tillig/MarantzVolumeMonitor/docs/architecture.md

# Architecture Reference

## Layers

The firmware uses a small layered architecture:

- **UI layer**: Screens, display rendering, touch handling, and screen navigation.
- **Network layer**: Wi-Fi connection management, SSDP/UPnP receiver discovery, and Marantz HTTP status access.
- **Storage layer**: Persistent device configuration using LittleFS.
- **Hardware layer**: TFT_eSPI display access and XPT2046 touch input.
- **Diagnostics**: An in-memory event log that any layer may write to, read by `DiagnosticsScreen` and `DiagnosticsServer`.

Screens should not perform network I/O directly. They should delegate network work to the network layer and persistence to `ConfigStore`.

## Source Layout

```text
src/
├── main.cpp
├── diagnostics/
│   ├── DeviceInfo.h/.cpp
│   └── DiagnosticLog.h/.cpp
├── network/
│   ├── DiagnosticsServer.h/.cpp
│   ├── MarantzClient.h/.cpp
│   ├── ReceiverDiscovery.h/.cpp
│   ├── ReceiverMonitor.h/.cpp
│   └── WiFiManager.h/.cpp
├── storage/
│   └── ConfigStore.h/.cpp
└── ui/
    ├── DisplayManager.h/.cpp
    ├── IconRenderer.h/.cpp
    ├── MaterialStyle.h/.cpp
    ├── ScreenManager.h/.cpp
    ├── TouchManager.h/.cpp
    ├── assets/
    │   └── IconBitmaps.h/.cpp
    └── Screens/
        ├── HomeScreen.h/.cpp
        ├── SettingsScreen.h/.cpp
        ├── CurrentSettingsScreen.h/.cpp
        ├── DiagnosticsScreen.h/.cpp
        ├── NetworkListScreen.h/.cpp
        ├── KeyboardScreen.h/.cpp
        ├── SetupStatusScreen.h/.cpp
        ├── ReceiverListScreen.h/.cpp
        ├── ReceiverIpScreen.h/.cpp
        ├── ReceiverStatusScreen.h/.cpp
        ├── ResetDefaultsScreen.h/.cpp
        └── CalibrationScreen.h/.cpp
```

Feature work may add classes inside these existing layer folders. New cross-layer behavior should keep the ownership boundary clear: UI presents state and handles touch, network classes perform network operations, and storage classes read or write persistent configuration.

## Runtime Flow

1. Boot initializes display, touch, and LittleFS-backed configuration storage, then attempts Wi-Fi auto-connect, applies any saved receiver IP, restores the saved touch-calibration profile if it is usable, and starts the diagnostics HTTP server. `WiFiManager` retries the saved network from the main loop whenever it stays disconnected.
2. `HomeScreen` is the first screen and classifies the current state as Wi-Fi setup required, Wi-Fi connecting, receiver setup required, receiver connecting, receiver unavailable, receiver off, or live.
3. If Wi-Fi is not configured, the touchscreen flow branches through `NetworkListScreen`, `KeyboardScreen`, and `SetupStatusScreen` to collect and save credentials.
4. If a receiver is not configured, the setup flow branches through `ReceiverListScreen`, `ReceiverIpScreen`, and `ReceiverStatusScreen` to discover or verify a receiver address before saving it.
5. `SettingsScreen` provides access to `Current Settings`, `Volume Display Scale`, Wi-Fi setup, receiver setup, touch calibration, `Diagnostics`, and `Reset To Defaults`, with pagination when all entries do not fit cleanly on one page.
6. `ReceiverMonitor` polls the saved receiver about once per second on a background FreeRTOS task, so status fetches never block the UI loop, and pauses when no screen has read status for a few seconds. `HomeScreen` redraws as soon as a new result lands, and `CurrentSettingsScreen` reads it about once per second. Identity lookups in `CurrentSettingsScreen` and receiver verification still run on the UI loop.
7. The live Home Screen renders normalized volume (`receiver dB + 80`), source, listening mode, audio-family icons, and receiver-off blank/backlight behavior.
8. `CalibrationScreen` owns the guided 9-point calibration session UI, while `TouchManager` owns runtime profile validation, mapping, and default-vs-active calibration application.
9. `ResetDefaultsScreen` owns the selective reset confirmation UI, while `ConfigStore` owns the actual config mutations for `Wi-Fi`, `Receiver`, and `Calibration`.

## Persisted Configuration

`ConfigStore` stores the device configuration in `/config.json` on LittleFS. The current schema includes:

- `wifiSsid`
- `wifiPassword`
- `receiverIp`
- `brightness`
- `useDbScale`
- `touchCalibration` (optional saved affine touch profile)

The active on-device UI currently uses the Wi-Fi, receiver, `useDbScale`, and optional `touchCalibration` fields. `touchCalibration` is stored only after a successful on-device calibration and is ignored if it becomes unreadable or unusable, in which case the firmware falls back to the shipped default touch profile.

## Documentation Roles

- `README.md` explains how to use and consume the project.
- `CONTRIBUTING.md` explains how to build, validate, and contribute.
- `docs/` contains durable hardware, UI, and architecture references.
- `specs/NNN-*` contains Spec Kit feature definitions, plans, contracts, quickstarts, and tasks.
