tillig/MarantzVolumeMonitor/specs/012-touch-calibration-persistence/checklists/requirements.md

# Specification Quality Checklist: Touch Calibration Persistence

**Purpose**: Validate specification completeness and quality before proceeding to planning
**Created**: 2026-06-12
**Feature**: [spec.md](../spec.md)

## Content Quality

- [x] No implementation details (languages, frameworks, APIs)
- [x] Focused on user value and business needs
- [x] Written for non-technical stakeholders
- [x] All mandatory sections completed

## Requirement Completeness

- [x] No [NEEDS CLARIFICATION] markers remain
- [x] Requirements are testable and unambiguous
- [x] Success criteria are measurable
- [x] Success criteria are technology-agnostic (no implementation details)
- [x] All acceptance scenarios are defined
- [x] Edge cases are identified
- [x] Scope is clearly bounded
- [x] Dependencies and assumptions identified

## Feature Readiness

- [x] All functional requirements have clear acceptance criteria
- [x] User scenarios cover primary flows
- [x] Feature meets measurable outcomes defined in Success Criteria
- [x] No implementation details leak into specification

## Notes

- Validation completed on 2026-06-12.
- The specification intentionally frames calibration as an on-device setup outcome and avoids committing to a specific storage schema or math model at the spec stage.
