tillig/MarantzVolumeMonitor/specs/010-display-current-settings/checklists/requirements.md

# Specification Quality Checklist: Display Current Settings

**Purpose**: Validate specification completeness and quality before proceeding to planning
**Created**: 2026-06-11
**Feature**: [spec.md](../spec.md)

## Content Quality

- [x] No implementation details (languages, frameworks, APIs)
- [x] Focused on user value and business needs
- [x] Written for non-technical stakeholders
- [x] All mandatory sections completed

## Requirement Completeness

- [x] No [NEEDS CLARIFICATION] markers remain
- [x] Requirements are testable and unambiguous
- [x] Success criteria are measurable
- [x] Success criteria are technology-agnostic (no implementation details)
- [x] All acceptance scenarios are defined
- [x] Edge cases are identified
- [x] Scope is clearly bounded
- [x] Dependencies and assumptions identified

## Feature Readiness

- [x] All functional requirements have clear acceptance criteria
- [x] User scenarios cover primary flows
- [x] Feature meets measurable outcomes defined in Success Criteria
- [x] No implementation details leak into specification

## Notes

- Validation pass 1 completed on 2026-06-11 for the initial draft.
- Validation pass 2 completed on 2026-06-11 after refining the feature to use a dedicated read-only `Current Settings` screen, first-position menu entry, and Material-compatible overflow handling for the expanded settings menu. All checklist items pass with no remaining clarification markers.
