tillig/MarantzVolumeMonitor/specs/006-material-design/checklists/requirements.md

# Specification Quality Checklist: Material Design UI

**Purpose**: Validate specification completeness and quality before proceeding to planning **Created**: 2026-06-04 **Feature**: [spec.md](../spec.md)

## Content Quality

- [x] No implementation details (languages, frameworks, APIs)
- [x] Focused on user value and business needs
- [x] Written for non-technical stakeholders
- [x] All mandatory sections completed

## Requirement Completeness

- [x] No [NEEDS CLARIFICATION] markers remain
- [x] Requirements are testable and unambiguous
- [x] Success criteria are measurable
- [x] Success criteria are technology-agnostic (no implementation details)
- [x] All acceptance scenarios are defined
- [x] Edge cases are identified
- [x] Scope is clearly bounded
- [x] Dependencies and assumptions identified

## Feature Readiness

- [x] All functional requirements have clear acceptance criteria
- [x] User scenarios cover primary flows
- [x] Feature meets measurable outcomes defined in Success Criteria
- [x] No implementation details leak into specification

## Notes

- Validation pass 1: All checklist items pass. No clarification markers remain.
- Validation pass 2: Requested consistency refinements for buttons, selection lists, searching screens, and progress feedback remain within the approved feature scope and preserve checklist compliance.
- Clarification pass: Four accepted clarifications were integrated without checklist regressions.
