tillig/MarantzVolumeMonitor/specs/005-bitmap-icons/checklists/requirements.md

# Specification Quality Checklist: Bitmap Icon Assets

**Purpose**: Validate specification completeness and quality before proceeding to planning **Created**: 2026-06-04 **Feature**: [spec.md](../spec.md)

## Content Quality

- [x] No implementation details (languages, frameworks, APIs)
- [x] Focused on user value and business needs
- [x] Written for non-technical stakeholders
- [x] All mandatory sections completed

## Requirement Completeness

- [x] No [NEEDS CLARIFICATION] markers remain
- [x] Requirements are testable and unambiguous
- [x] Success criteria are measurable
- [x] Success criteria are technology-agnostic (no implementation details)
- [x] All acceptance scenarios are defined
- [x] Edge cases are identified
- [x] Scope is clearly bounded
- [x] Dependencies and assumptions identified

## Feature Readiness

- [x] All functional requirements have clear acceptance criteria
- [x] User scenarios cover primary flows
- [x] Feature meets measurable outcomes defined in Success Criteria
- [x] No implementation details leak into specification

## Notes

- Validation pass 4 completed on 2026-06-04 after recording the supplied DTS SVG source candidate and project-owner approval for both Dolby and DTS logo sources. No blocking issues found.
- Validation pass 3 completed on 2026-06-04 after recording the supplied Dolby SVG source candidate. No blocking issues found.
- Validation pass 2 completed on 2026-06-04 after adding explicit home, settings, keyboard, Material Design, and audio-family icon requirements. No blocking issues found.
- Validation pass 1 completed on 2026-06-04. No blocking issues found.
- The feature description explicitly requests bitmap icon assets, so the specification treats bitmap assets as the desired deliverable while avoiding implementation-specific storage, encoding, or code integration details.
