tillig/MarantzVolumeMonitor/specs/007-display-volume-level/checklists/requirements.md

# Specification Quality Checklist: Display Volume Level

**Purpose**: Validate specification completeness and quality before proceeding to planning **Created**: 2026-06-05 **Feature**: [Link to spec.md](../spec.md)

## Content Quality

- [x] No implementation details (languages, frameworks, APIs)
- [x] Focused on user value and business needs
- [x] Written for non-technical stakeholders
- [x] All mandatory sections completed

## Requirement Completeness

- [x] No [NEEDS CLARIFICATION] markers remain
- [x] Requirements are testable and unambiguous
- [x] Success criteria are measurable
- [x] Success criteria are technology-agnostic (no implementation details)
- [x] All acceptance scenarios are defined
- [x] Edge cases are identified
- [x] Scope is clearly bounded
- [x] Dependencies and assumptions identified

## Feature Readiness

- [x] All functional requirements have clear acceptance criteria
- [x] User scenarios cover primary flows
- [x] Feature meets measurable outcomes defined in Success Criteria
- [x] No implementation details leak into specification

## Notes

- Validation remains passing after refining the spec to distinguish powered-off and unavailable receiver states, to require smooth animated gauge and numeric volume transitions, and to require partial redraws during animation instead of full-screen flashing. No clarification round was required.
