tillig/MarantzVolumeMonitor/specs/001-hardware-spike/spec.md

# Feature Specification: Hardware Integration Spike (Hello World)

**Feature Branch**: `feature/001-hardware-spike`

**Created**: 2026-05-24

**Status**: Active

**Input**: User request for a "Hello World" to verify ESP32 + TFT/SPI + PlatformIO.

## User Scenarios and Testing

### User Story 1 - Verify TFT Display (Priority: P1)

As a developer, I want to see a "Hello World" message on the TFT display so I know the wiring and driver (TFT_eSPI) are correct.

**Why this priority**: Fundamental blocker for all UI features.

**Independent Test**: Build and upload. Success if "Hello World" is visible on the screen.

**Acceptance Scenarios**:

1. **Given** the ESP32 is powered and connected to the TFT, **When** the code runs, **Then** the screen background is black and white text "Hello World" is centered.

---

### User Story 2 - Verify Touch Controller (Priority: P2)

As a developer, I want the "Hello World" text color to change when I touch the screen so I know the touch controller (XPT2046) is working.

**Why this priority**: Required for all interactive features.

**Independent Test**: Touch the screen. Success if text color cycles (e.g., White -> Green -> Blue).

**Acceptance Scenarios**:

1. **Given** the "Hello World" screen is active, **When** the user touches any part of the screen, **Then** the text color changes to a different high-contrast color.

---

## Requirements

### Functional Requirements

- **FR-001**: System MUST initialize the TFT display using the `TFT_eSPI` library.
- **FR-002**: System MUST initialize the XPT2046 touch controller.
- **FR-003**: System MUST display "Hello World" in a large, readable font (e.g., 24pt+).
- **FR-004**: System MUST detect touch events and provide visual feedback (color change).
- **FR-005**: System MUST log "Hardware Spike Started" to Serial at 115200 baud.
- **FR-006**: System MUST log a detailed error to Serial and halt execution if TFT or Touch initialization fails.

### Key Entities

- **Display**: The physical 4" TFT module.
- **TouchPoint**: The (x, y) coordinates and pressure of a touch event.

## Success Criteria

### Measurable Outcomes

- **SC-001**: "Hello World" text is rendered within 2 seconds of boot.
- **SC-002**: Touch response (color change) occurs within 100ms of interaction.
- **SC-003**: PlatformIO successfully compiles and uploads without manual library hacks.

## Assumptions

- Hardware is wired according to `docs/hardware.md`.
- `platformio.ini` is correctly configured for the ST7796 driver and ESP32 pinout.
- The user has a stable USB connection to the ESP32.

## Clarifications

### Session 2026-05-24

- Q: Should the spike use the existing architecture (Screen classes) or be a raw `main.cpp` test? → A: Use a raw `main.cpp` approach for the simplest possible verification, then integrate into the architecture if successful.
- Q: How should the system handle hardware initialization failure? → A: Log detailed error to Serial and stop execution.
on.
