tillig/MarantzVolumeMonitor/assets/icons/inventory.md

# Icon Inventory

This inventory records every icon source and generated firmware target used by the on-device UI. Material-compatible custom artwork is kept in `assets/icons/source/`; generated previews are in `assets/icons/generated/`; firmware masks are in `src/ui/assets/IconBitmaps.h` and `src/ui/assets/IconBitmaps.cpp`.

| Asset ID | Meaning | Category | Source Type | Source | License / Usage Note | Target Size | Minimum Display Size | Generated Symbol | Screen Usage | Runtime Colors |
| --- | --- | --- | --- | --- | --- | --- | --- | --- | --- | --- |
| `audio-dolby` | Dolby audio family | `audio-family` | `brand-logo` | `assets/icons/source/audio-dolby.svg`; upstream `https://upload.wikimedia.org/wikipedia/commons/3/32/Dolby_logo.svg` | Project owner supplied this SVG source candidate and approved use for this project on 2026-06-04. Dolby remains a trademark of its owner. | `102x32` | `102x32` | `Icons::AUDIO_DOLBY` | Home audio family row | Active lit green; inactive dark gray |
| `audio-dts` | DTS audio family | `audio-family` | `brand-logo` | `assets/icons/source/audio-dts.svg`; upstream `https://upload.wikimedia.org/wikipedia/commons/3/3d/DTS_logo.svg` | Project owner supplied this SVG source candidate and approved use for this project on 2026-06-04. DTS remains a trademark of its owner. | `102x32` | `102x32` | `Icons::AUDIO_DTS` | Home audio family row | Active lit green; inactive dark gray |
| `audio-pcm` | PCM audio family | `audio-family` | `custom` | `assets/icons/source/audio-pcm.svg` | Custom Material-compatible pulse-code step waveform. Chosen to read as digital/uncompressed audio without implying a brand. | `102x32` | `102x32` | `Icons::AUDIO_PCM` | Home audio family row | Active lit green; inactive dark gray |
| `audio-other` | Other audio family | `audio-family` | `custom` | `assets/icons/source/audio-other.svg` | Custom Material-compatible waveform with question mark. Chosen to communicate uncategorized audio without implying an error. | `102x32` | `102x32` | `Icons::AUDIO_OTHER` | Home audio family row | Active lit green; inactive dark gray |
| `settings` | Open settings | `control` | `material-symbol` | `assets/icons/source/settings.svg`; Material Symbol: `settings` | Material Symbols are Apache 2.0 licensed. | `24x24` | `24x24` | `Icons::SETTINGS` | Home top-right settings control | Text secondary |
| `chevron-right` | Navigate to listed setting | `control` | `material-symbol` | `assets/icons/source/chevron-right.svg`; Material Symbol: `chevron_right` | Material Symbols are Apache 2.0 licensed. | `24x24` | `24x24` | `Icons::CHEVRON_RIGHT` | Settings rows | Row text color |
| `keyboard-caps-lock` | Toggle caps lock | `control` | `material-symbol` | `assets/icons/source/keyboard-caps-lock.svg`; Material Symbol: `keyboard_capslock` | Material Symbols are Apache 2.0 licensed. | `24x24` | `24x24` | `Icons::KEYBOARD_CAPS_LOCK` | Keyboard function key | Function key foreground; selected dark text |
| `keyboard-visibility` | Show or hide keyboard input | `control` | `material-symbol` | `assets/icons/source/keyboard-visibility.svg`; Material Symbol: `visibility` | Material Symbols are Apache 2.0 licensed. | `24x24` | `24x24` | `Icons::KEYBOARD_VISIBILITY` | Keyboard function key | Function key foreground |
| `keyboard-visibility-off` | Hide visible keyboard input | `control` | `material-symbol` | `assets/icons/source/keyboard-visibility-off.svg`; Material Symbol: `visibility_off` | Material Symbols are Apache 2.0 licensed. | `24x24` | `24x24` | `Icons::KEYBOARD_VISIBILITY_OFF` | Keyboard function key when input is visible | Function key foreground |
| `keyboard-backspace` | Delete previous character | `control` | `material-symbol` | `assets/icons/source/keyboard-backspace.svg`; Material Symbol: `backspace` | Material Symbols are Apache 2.0 licensed. | `24x24` | `24x24` | `Icons::KEYBOARD_BACKSPACE` | Keyboard function key | Function key foreground |
| `keyboard-ok` | Confirm keyboard input | `control` | `material-symbol` | `assets/icons/source/keyboard-ok.svg`; Material Symbol: `check` | Material Symbols are Apache 2.0 licensed. | `24x24` | `24x24` | `Icons::KEYBOARD_OK` | Keyboard function key | White on confirm key |
| `keyboard-cancel` | Cancel keyboard input | `control` | `material-symbol` | `assets/icons/source/keyboard-cancel.svg`; Material Symbol: `close` | Material Symbols are Apache 2.0 licensed. | `24x24` | `24x24` | `Icons::KEYBOARD_CANCEL` | Keyboard function key | White on cancel key |
| `scan` | Search or discovery in progress | `status` | `material-symbol` | `assets/icons/source/scan.svg`; Material Symbol: `search` | Material Symbols are Apache 2.0 licensed. | `32x32` | `32x32` | `Icons::SCAN` | Wi-Fi and receiver setup searching states; Settings diagnostics row and Diagnostics header | Text secondary |
| `manual-entry` | Enter details manually | `control` | `material-symbol` | `assets/icons/source/manual-entry.svg`; Material Symbol: `edit` | Material Symbols are Apache 2.0 licensed. | `24x24` | `24x24` | `Icons::MANUAL_ENTRY` | Wi-Fi and receiver setup manual actions | Text secondary |
| `retry` | Retry failed action | `control` | `material-symbol` | `assets/icons/source/retry.svg`; Material Symbol: `refresh` | Material Symbols are Apache 2.0 licensed. | `24x24` | `24x24` | `Icons::RETRY` | Setup failure actions | Text primary |
| `success` | Completed successfully | `status` | `material-symbol` | `assets/icons/source/success.svg`; Material Symbol: `check_circle` | Material Symbols are Apache 2.0 licensed. | `48x48` | `32x32` | `Icons::SUCCESS` | Setup success states | Lit green |
| `warning` | Recoverable warning | `status` | `material-symbol` | `assets/icons/source/warning.svg`; Material Symbol: `warning` | Material Symbols are Apache 2.0 licensed. | `48x48` | `32x32` | `Icons::WARNING` | Recoverable setup warnings | Warning yellow |
| `failure` | Failed action | `status` | `material-symbol` | `assets/icons/source/failure.svg`; Material Symbol: `cancel` | Material Symbols are Apache 2.0 licensed. | `48x48` | `32x32` | `Icons::FAILURE` | Setup failure states | Error red |
| `wifi` | Wi-Fi state | `status` | `material-symbol` | `assets/icons/source/wifi.svg`; Material Symbol: `wifi` | Material Symbols are Apache 2.0 licensed. | `32x32` | `32x32` | `Icons::WIFI` | Wi-Fi setup/status | Text secondary |
| `touch-calibration` | Open touch calibration or calibration action | `setup` | `custom` | `assets/icons/source/touch-calibration.svg` | Custom Material-compatible crosshair icon for touch calibration entry and action buttons. | `24x24` | `24x24` | `Icons::TOUCH_CALIBRATION` | Settings calibration row; boot/setup calibrate action | Text secondary or button foreground |
| `receiver` | Receiver state | `setup` | `custom` | `assets/icons/source/receiver.svg` | Custom Material-compatible receiver front-panel icon. | `32x32` | `32x32` | `Icons::RECEIVER` | Receiver setup/status | Text secondary |
