tillig/MarantzVolumeMonitor/assets/box/box-top.obj

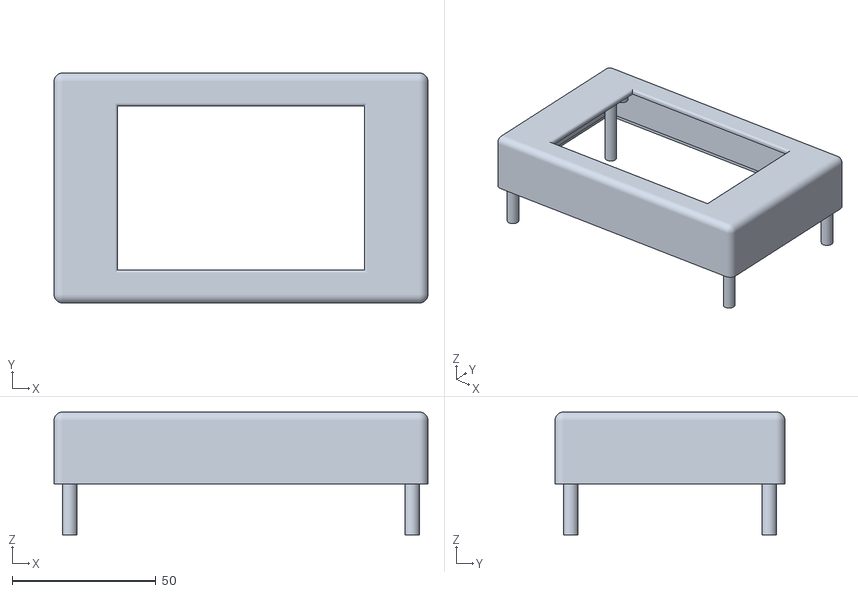
[picture p3: CAD file, 2026-06-12]
assets/box/box-top.obj
130.0 x 80.0 x 42.8
