tillig/MarantzVolumeMonitor/assets/box/box-bottom.obj

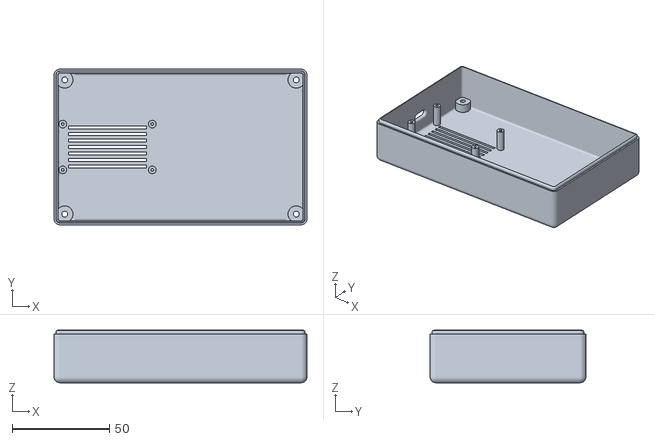
[picture p4: CAD file, 2026-06-12]
assets/box/box-bottom.obj
130.0 x 80.0 x 27.0
