tillig/MarantzVolumeMonitor/specs/003-wifi-setup-ui/data-model.md

# Data Model: WiFi Setup UI

## Entities

### WiFiNetwork (In-Memory)

Represents a network discovered during a scan.

| Field | Type | Description |
| :--- | :--- | :--- |
| ssid | String | Service Set Identifier |
| rssi | int32_t | Signal strength in dBm |
| encryptionType | uint8_t | WiFi security type (WPA2_PSK only for v2) |

### NetworkCredentials (Persistent)

Stored in `config.json` via `LittleFS`.

| Field | Type | Validation |
| :--- | :--- | :--- |
| wifiSsid | String | 1-32 chars |
| wifiPassword | String | 8-63 chars (for WPA2) |

## State Transitions

```mermaid
graph TD
    IDLE[Unconfigured State] -->|Tap Screen| SCANNING[WiFi Scanning]
    SCANNING -->|Scan Complete| LIST[Display Network List]
    LIST -->|Select SSID| KEYBOARD[Password Entry]
    LIST -->|Manual Button| MANUAL_SSID[SSID Entry]
    MANUAL_SSID -->|Submit| KEYBOARD
    KEYBOARD -->|Submit| CONNECTING[Attempt Connection]
    CONNECTING -->|Success| HOME[Home Screen]
    CONNECTING -->|Failure| KEYBOARD
```
