tillig/MarantzVolumeMonitor/(threads)

Thread 2 (2018-04-10):

Move source to "MarantzVolumeMonitor" folder

tillig, 2018-04-10:
Original request - PR #1

In order for the Arduino IDE to work with the "download" option in GitHub the .ino and other source files need to be in a child folder named the same as the .ino - "MarantzVolumeMonitor." GitHub appends the version/commit hash to the folder in the zip so using the download option doesn't work out of the box without a manual folder rename step.

tillig, 2018-04-10:
In solving this it's a priority to ensure that Visual Studio and Visual Micro still work with the final file layout since that's my primary IDE.

tillig, 2018-06-01:
Pushed the update for this just now.

Closed 2018-06-01.

Thread 3 (2018-07-15):

Setup UI incorrect

tillig, 2018-07-15:
After rearranging the solution organization and updating some libraries, the UI for configuring the Arduino with the IP address of the receiver doesn't seem to work. Instead of displaying what I expect...

```
Receiver IP:
123.123.123.123
```

It instead displays an odd format that doesn't allow you to configure things.

```
Receiver IP:
..001
```

I've found when odd behavior like this shows up it usually has to do with the Arduino running out of memory. Perhaps some of the circuit breaker and logging statements recently added have added overhead.

The workaround is to manually set the IP address [just before the initial retrieval of the configuration](https://github.com/tillig/MarantzVolumeMonitor/blob/adf075f65135a70f009e8a2b71bd26488526b300/MarantzVolumeMonitor/MarantzVolumeMonitor.ino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) and never actually try to use the UI.

```cpp
// Sub in your own receiver's address
ConfigurationManagerClass.setConfiguration(IPAddress(192, 168, 1, 204));
```
