tillig/MarantzVolumeMonitor/src/network/MarantzClient.h

#ifndef MARANTZ_CLIENT_H
#define MARANTZ_CLIENT_H

#include <Arduino.h>
#include <HTTPClient.h>
#include <WiFi.h>

struct MarantzStatus {
    bool power;
    bool powerKnown;
    float volume;
    bool hasVolume;
    String input;
    String mode;
    bool isValid;
    // HTTP status code, or a negative HTTPClient error code when the request did not complete.
    int httpCode;

    MarantzStatus()
        : power(false), powerKnown(false), volume(-80.0), hasVolume(false), input(""), mode(""), isValid(false),
          httpCode(0) {}
};

class MarantzClient {
public:
    static MarantzClient& getInstance() {
        static MarantzClient instance;
        return instance;
    }

    MarantzStatus fetchStatus(const String& ip);
    bool verifyReceiver(const String& ip, MarantzStatus* verifiedStatus = nullptr);

private:
    MarantzClient() {}

    static String extractValue(const String& xml, const String& tag);
    String extractStatusValue(const String& xml, const String& tag);
    String extractPreferredStatusValue(const String& xml,
                                       const String& tag,
                                       const char* const nestedTags[],
                                       size_t nestedTagCount);
    String extractFirstStatusValue(const String& xml, const char* const tags[], size_t tagCount);
};

#endif
