tillig/MarantzVolumeMonitor/src/ui/Screens/HomeScreen.h

#ifndef HOME_SCREEN_H
#define HOME_SCREEN_H

#include "Screen.h"
#include "../MaterialStyle.h"
#include "../../network/MarantzClient.h"
#include "../../storage/ConfigStore.h"

class HomeScreen : public Screen {
public:
    enum class DisplayState {
        WifiSetupRequired,
        WifiConnecting,
        ReceiverSetupRequired,
        ReceiverConnecting,
        ReceiverUnavailable,
        ReceiverOffVisible,
        ReceiverOffBlank,
        Live
    };

    HomeScreen();
    void draw() override;
    void update() override;
    void handleTouch(TS_Point p) override;

private:
    struct Rect {
        int x;
        int y;
        int w;
        int h;
    };

    struct VolumeAnimation {
        bool active = false;
        float startVolume = -80.0f;
        float displayedVolume = -80.0f;
        float targetVolume = -80.0f;
        float lastRenderedVolume = -80.0f;
        String lastRenderedText;
        uint8_t lastRenderedFont = 0;
        bool lastRenderedHadNegativeSign = false;
        uint32_t startMs = 0;
        uint32_t durationMs = 0;
        uint32_t lastFrameMs = 0;
    };

    struct ReceiverOffTimer {
        uint32_t startedAtMs = 0;
        uint32_t durationMs = 3000;
        bool active = false;
    };

    struct ReceiverOffWakeCandidate {
        uint32_t startedAtMs = 0;
        TS_Point initialMapped;
        TS_Point initialRaw;
        bool active = false;
    };

    MarantzStatus _lastStatus;
    DeviceConfig _config;
    DisplayState _displayState;
    bool _hasWifiConfig = false;
    bool _hasReceiverConfig = false;
    bool _isWifiConnected = false;
    bool _hasReceiverStatus = false;
    uint32_t _receiverStatusSequence = 0;
    String _ipAddress;
    uint32_t _lastRefreshMs = 0;
    VolumeAnimation _volumeAnimation;
    ReceiverOffTimer _receiverOffTimer;
    ReceiverOffWakeCandidate _receiverOffWakeCandidate;

    static void drawSettingsButton();
    void drawAudioFamilyIcons();
    void drawSetupState();
    static void drawCalibrationButton();
    void loadStoredConfig();
    void refreshState();
    DisplayState classifyDisplayState(const MarantzStatus& status) const;
    DisplayState resolveDisplayState(DisplayState classifiedState) const;
    void setDisplayState(DisplayState state, uint32_t now);
    void startReceiverOffTimer(uint32_t now);
    void stopReceiverOffTimer();
    void startReceiverOffWakeCandidate(TS_Point mappedPoint, TS_Point rawPoint, uint32_t now);
    void clearReceiverOffWakeCandidate();
    bool updateReceiverOffWakeCandidate(uint32_t now);
    bool isReceiverOffTimerExpired(uint32_t now) const;
    static bool isCalibrationButtonPressed(TS_Point p);
    static bool isSettingsButtonPressed(TS_Point p);
    bool isSettingsAccessible() const;
    int activeAudioFamilyIndex() const;
    String formatVolume(float volume) const;
    float numericDisplayValue(float normalizedVolume) const;
    bool volumeHasNegativeSign(float normalizedVolume) const;
    String displaySource() const;
    String displayMode() const;
    static float displayVolume(float receiverVolume);
    static float volumeToPercent(float volume);
    static uint8_t volumeFont(const String& valueText);
    static uint32_t animationDurationFor(float startVolume, float targetVolume);
    float animationProgress(uint32_t now) const;
    static float easedAnimationProgress(float progress);
    void syncDisplayedVolume(float volume);
    void retargetVolumeAnimation(float targetVolume);
    void stopVolumeAnimation();
    void redrawLiveVolumeRegion();
    void redrawLiveVolumeFrame(bool forceFull = false);
    void redrawLiveMetadataRegion();
    bool tickVolumeAnimation(uint32_t now);
    void renderLiveVolumeRegion(TFT_eSPI& target, int originX, int originY);
    static Rect liveGaugeRegion();
    static Rect liveSourceRegion();
    static Rect liveModeRegion();
    static Rect liveAudioIconsRegion();
    Rect volumeTextRegion(float volume) const;
    static int volumeNegativeSignWidth(TFT_eSPI& target);
    static int volumeSweep(float volume);
    static uint16_t volumeArcColor(int sweep);
    static void drawVolumeArcDelta(TFT_eSPI& target, float previousVolume, float currentVolume);
    static void drawVolumeArcSegment(TFT_eSPI& target, int x, int y, int r, int startSweep, int endSweep, bool colored);
    static void drawVolumeCap(TFT_eSPI& target, int x, int y, int r, int sweep, uint16_t color);
    void drawVolumeValueText(TFT_eSPI& target, const String& valueText, uint8_t font, int centerX, int centerY);
    static void drawVolumeNegativeSign(TFT_eSPI& target, int x, int centerY);
    void drawVolumeValueTextDelta(TFT_eSPI& target, const String& valueText, uint8_t font);
    static void drawVolumeTextAt(TFT_eSPI& target, const String& text, int x, int y, uint8_t font);
    static void clearRect(const Rect& rect);
    static void drawReceiverStatusState(const String& title, const String& message, MaterialStyle::StatusKind kind);

    // Layout-specific drawing
    void drawLayoutUnified();

    // Helper for Arc Gauge
    static void drawVolumeArc(TFT_eSPI& target, int x, int y, int r, float volume);
};
#endif
