tillig/MarantzVolumeMonitor/src/ui/Screens/ResetDefaultsScreen.h

#ifndef RESET_DEFAULTS_SCREEN_H
#define RESET_DEFAULTS_SCREEN_H

#include "Screen.h"
#include "../../storage/ConfigStore.h"

class ResetDefaultsScreen : public Screen {
public:
    void draw() override;
    void update() override;
    void handleTouch(TS_Point p) override;

private:
    enum class ResetType { Wifi, Receiver, Calibration };

    enum class Mode { ChoosingType, Confirming, Completed };

    Mode _mode = Mode::ChoosingType;
    ResetType _selectedType = ResetType::Wifi;
    bool _applyFailed = false;

    static void drawSelection(TFT_eSPI& tft);
    void drawConfirmation(TFT_eSPI& tft);
    static void drawCompleted(TFT_eSPI& tft);
    static bool isChoicePressed(TS_Point p, int index);
    bool isCancelPressed(TS_Point p) const;
    static bool isResetPressed(TS_Point p);
    static bool isOkPressed(TS_Point p);
    static const char* labelFor(ResetType type);
    static const char* detailFor(ResetType type);
    static ConfigStore::ResetTarget configTargetFor(ResetType type);
    void applyReset();
};

#endif
