tillig/MarantzVolumeMonitor/(commit log)

2017-02-26 Determined LCD shield button readings.
2017-03-11 Moved button read ops into a separate class.
2017-03-11 Moved configuration UI handling to separate class.
    [ConfigurationInterface.h]
2017-03-12 Configuration load/save in EEPROM.
    [ConfigurationManager.h, ConfigurationSettings.h]
2017-03-16 Fixed incorrect receiver power setting.
    [MarantzClient.cpp]
2018-04-07 Fixed logic error causing occasional hang after all elements read.
    [MarantzClient.cpp]
2018-04-10 Better circuit breaker when receiver hangs on response.
2018-06-01 Updated folder structure for better compatibility with Arduino IDE.
    [ConfigurationInterface.h, ConfigurationManager.h, ConfigurationSettings.h]
2018-06-01 Note about using Arduino IDE.
2026-05-31 Initialized spec kit.
    [ConfigurationInterface.h, ConfigurationManager.h, ConfigurationSettings.h]
2026-05-31 Hardware spike for ESP32 touch controller. Touch is working and calibrated, but not yet integrated into the UI.
2026-05-31 Set up UI foundation for ESP32 rewrite (#5)
    * [Spec Kit] Add specification
    * [Spec Kit] Add implementation plan
    * [Spec Kit] Add tasks
    * [Spec Kit] Implementation progress
    * [Spec Kit] Add tasks
    * Fix hardware spike plans for clarity.
    * [Spec Kit] Implementation progress
    * [Spec Kit] Implementation progress
    * [Spec Kit] Implementation progress
    * [Spec Kit] Implementation progress
    [ConfigStore.cpp, ConfigStore.h, DisplayManager.h, HomeScreen.cpp, HomeScreen.h, main.cpp]
2026-06-03 Switch to Codex support.
2026-06-05 Material Design UI refresh
2026-06-11 Overhaul wiring diagrams and tables.
2026-06-11 Add current settings overview
2026-06-12 Add touch calibration persistence and reset defaults
    [CalibrationScreen.cpp, CalibrationScreen.h, ConfigStore.cpp, ConfigStore.h, CurrentSettingsScreen.cpp, DisplayManager.cpp, DisplayManager.h, HomeScreen.cpp]
2026-06-12 Add 3D models for box.
    [box-bottom.obj, box-top.obj]
2026-10-05 Pin pioarduino and update dependencies (#9)
    * Update pre-commit hooks and GitHub Actions.
    * Pin the pioarduino platform and library versions.
    CI resolved the registry espressif32 platform (Arduino core 2.x) while local builds used pioarduino (core 3.x), so CI never tested what gets flashed. cppcheck cannot parse the newer toolchain headers, so package headers are skipped and the findings that surfaced are fixed.
    * Move to the latest pioarduino platform and clang-format.
    CI builds and validates these; the corporate proxy blocks them on this machine.
    * Remove the unused calibration getter and home screen layout state.
    * Run CI on pushes to master, the default branch.
    * Cache the platfor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
    [CalibrationScreen.cpp, CalibrationScreen.h, ConfigStore.cpp, CurrentSettingsScreen.cpp, CurrentSettingsScreen.h, DisplayManager.h, HomeScreen.cpp, HomeScreen.h]
2026-10-05 Poll receiver status on a background task (#10)
    * Poll receiver status on a background task.
    Synchronous status fetches blocked the UI loop for up to the HTTP timeout whenever the receiver was slow or unreachable, so taps on the Receiver Unavailable screen were dropped.
    Fixes #7.
    * Poll the receiver only on demand and stop showing stale status.
    Home now shows Connecting to receiver, with Settings available, until the first result arrives, and refreshes as soon as each result lands. A result older than three seconds reads as unavailable.
    * Add the Spec Kit entry for background receiver polling.
    [CurrentSettingsScreen.cpp, HomeScreen.cpp, HomeScreen.h, MarantzClient.cpp, MarantzClient.h, ReceiverMonitor.cpp, ReceiverMonitor.h, main.cpp]
2026-10-05 Wi-Fi retry and diagnostics (#11)
    * Retry Wi-Fi on our own and add diagnostics.
    The Arduino core stops reconnecting after some failures and rejects new credentials while an attempt is still running, which left the monitor stuck on Connecting Wi-Fi and made good passwords look wrong. The firmware now retries with a radio restart, reports the driver's disconnect reason, and exposes recent events on-device and over HTTP.
    Fixes #8.
    * Suppress a cppcheck false positive in DiagnosticLog.
    * Fix the stricter cppcheck findings in the diagnostics changes.
    * Fix review findings in Wi-Fi retry and diagnostics.
    Resetting Wi-Fi stops the retry loop, retries log only the first attempt and reason chan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
    [DiagnosticsScreen.cpp, DiagnosticsScreen.h, DiagnosticsServer.h]
2026-10-05 Web flasher and tagged releases (#12)
    * Publish releases to a browser-based web flasher.
    Tagging v* builds the factory image, attaches it to a GitHub Release, and deploys an ESP Web Tools page to GitHub Pages, mirroring somfy-matter-remote. The image ends before the LittleFS partition, so one manifest both installs and updates.
    Fixes #6.
    * Deploy the flasher from the release workflow and fix review findings.
    The Pages deploy now runs after the release it serves, prerelease tags skip it, and the release build matches CI. FIRMWARE_VERSION is scoped to DeviceInfo.cpp so other objects don't rebuild on every commit.
2026-10-06 Document how to cut a release and pick its version.
